jsnhynh/orca/docs/_images/rob-commit-waveform.webp

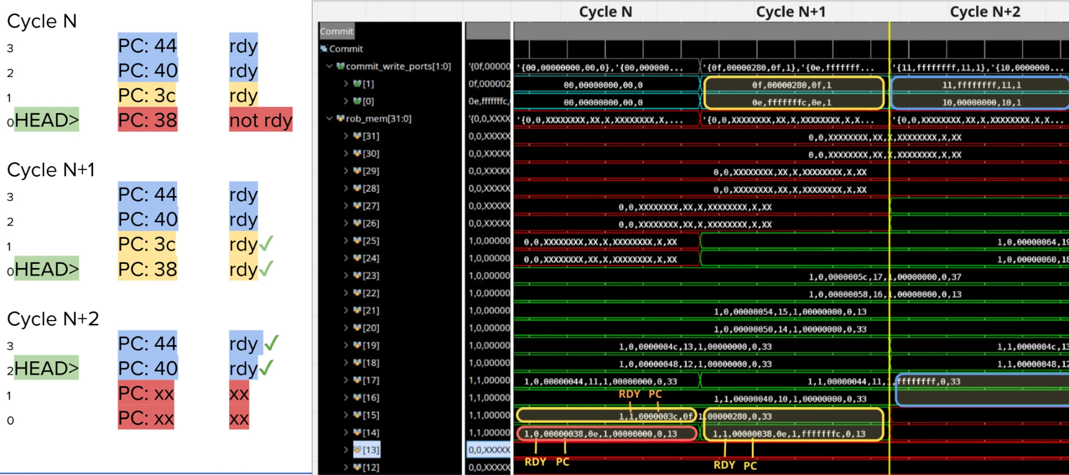
docs/_images/rob-commit-waveform.webp
