jsnhynh/orca/docs/bringup/asic-synthesis.html

Skip to content

ORCA

ORCA

Introduction

- Overview
- Results
- Building

Microarchitecture

- Core
  - Stage 0: Branch Prediction
  - Stage 1: Fetch
  - Stage 2: Decode
  - Stage 3: Rename
  - Stage 4: Dispatch
  - Stage 5: Issue
  - Stage 6: Execute
  - Stage 7: Writeback
  - Stage 8: Commit
  - M Extension: Multiply and Divide
  - A Extension: Atomics
  - Machine-Mode Traps
  - ISA and Software Contract
- Memory
  - L1 Caches
  - Boot ROM
  - DDR and Main Memory
- SoC
  - Interconnect and Clocks
  - Peripherals and Registers
  - FPGA and KV260 Boundary

Verification

- Verification

Bring-Up

- FPGA Bring-Up
- ASIC Synthesis
- Linux Bring-Up

Back to top

# ASIC Synthesis¶

Alongside the FPGA build, the core and its L1 caches (cpu) were synthesized to ASAP7 standard cells and timed with OpenSTA. The result is a pre-layout estimate at the typical corner (0.7 V): it measures the RTL’s logic depth and gives an approximate ASIC frequency, area and leakage for the core.

## 1. Purpose and Scope¶

FPGA timing hides logic depth. A CARRY8 chain and a 6-input LUT absorb structures that take many gate levels in standard cells, and on the KV260 routing makes up 60 to 75% of ORCA’s critical paths. A standard-cell estimate removes both effects and shows how deep the logic itself is, which the FPGA reports cannot.

The flow stops at a synthesized netlist. Physical design (placement, clock tree synthesis and routing) was left out of scope, since the goal was the RTL handoff point and not a full chip. OpenROAD placement remains open as the next step; it would replace the repair scripts described below and measure the real wire cost.

## 2. Yosys and OpenSTA Setup¶

./orca synth   # results in build/synth/cpu/

The flow uses Yosys with the slang SystemVerilog frontend, OpenSTA, and the ASAP7 platform from OpenROAD-flow-scripts, all installed outside the repository.

1. Read. Yosys reads the same rtl/ files as the FPGA build through slang, with cpu as the top. The SoC bus logic is left out.
2. Memories. gen_macros.py describes the ASAP7 fakeram macros to Yosys’s memory mapper, and each array becomes a macro or flops, whichever is smaller. Arrays with multiple write ports, or read in the same cycle their address arrives, become flops, and ROMs become logic. The library only has single-port macros without write masks, so a one-read one-write array uses the single-port cell with a second address bus at twice the area (an assumption, about 30,000 µm² of the total), and each group of bits written together gets its own macro.
3. Adders. Carry chains are mapped to Kogge-Stone prefix trees, the closest standard-cell equivalent to the FPGA carry chain.
4. Logic. ABC maps the remaining logic to regular-threshold (RVT) cells with a delay script, using the block’s input drive and output load.
5. Repair. The netlist is buffered, sized and threshold-mixed by the three scripts in the next section.
6. Timing. OpenSTA times the netlist against a bare 1 ns clock with no uncertainty, and against the handoff constraints in scripts/synth/orca.sdc: 50 ps of uncertainty for a future clock tree and 30% of each cycle reserved at the block boundary for the surrounding SoC. Both values are assumptions.

### Design Decision: One RTL for Both Flows¶

The FPGA and ASIC flows read the same RTL, with memories inferred by each tool. One exception was made. The retire counter adds up to 4 to a 64-bit value every cycle (two retire slots, each possibly a fused pair). On the FPGA this maps onto a carry chain, but Yosys built it as a ripple of about 35 gates, which left the estimate 69 ps short of 1 GHz. When XILINX is not defined, csr.sv uses small_add.sv, which adds the low bits normally and carries into the upper bits through an AND prefix. Vivado defines XILINX and keeps the plain +, so the closed FPGA design is unaffected. A tighter ABC delay target and a hierarchy-keeping option were tried first and did not fix the path.

## 3. Timing Repair¶

Commercial synthesis tools optimize against timing during mapping: they build buffer trees for high fan-out nets, size gates on critical paths and choose a threshold voltage per gate. Yosys and ABC restructure logic for delay but do none of these. ABC also does not see the load of flop and macro pins, so high fan-out nets come out of synthesis driven by single small gates. Three scripts were written to stand in for that step, and they change only cells and wiring, never logic:

- buffer_nets.py splits each net above a fan-out limit into a balanced buffer tree. A second pass reads each sink’s slack from a timing run, keeps the worst sinks on the driver and places the rest behind the tree.
- size_cells.py takes the worst path to each failing endpoint and upsizes its slowest stages by one drive strength. A pass that fails to improve worst slack is reverted, and the next pass touches half as many cells.
- mix_vt.py moves gates on failing paths from RVT to low threshold (LVT) until the clock has the requested margin. On a failing path with no RVT gate left, it upsizes the smallest gates instead.

Run | Worst path | Clock | Logic and flop leakage
Yosys only, RVT | 2,160 ps | about 463 MHz
Yosys only, LVT | 1,663 ps | about 601 MHz
Buffered and sized, RVT | 1,297 ps | about 771 MHz | 0.06 mW
Buffered and sized, LVT | 991 ps | about 1.01 GHz | 0.62 mW
Buffered and sized, SLVT | 911 ps | about 1.1 GHz | 6.2 mW
Shipped: buffered, sized, 98.2% RVT and 1.8% LVT | 1 GHz met | 1 GHz | about 0.09 mW

Buffering and sizing alone removed 40% of the raw path delay.

### Design Decision: Selective LVT vs a Single Threshold¶

An all-RVT netlist stops at about 771 MHz, and an all-LVT netlist reaches 1 GHz at 0.62 mW of logic and flop leakage. Moving only the gates on failing paths to LVT reaches 1 GHz with 1.8% of the cells at LVT and 0.09 mW of leakage. SLVT was not used for the shipped netlist.

## 4. Results¶

| Value
Clock | 1 GHz, typical corner, 0.7 V
Worst setup slack | +30.7 ps on the bare clock; +0.7 ps at the sizing target (30 ps uncertainty); 0 failing endpoints; 150 endpoints within 50 ps
Handoff constraints | misses by 241 ps; the worst path is minstret_r to the perf_stats output port, inside the assumed 30% boundary budget
Threshold mix | 98.2% RVT, 1.8% LVT
Area | about 0.081 mm²: RAM macros 51%, logic 29%, flops 13%, buffers 7%
Logic and flop leakage | about 0.09 mW (library estimate)
Total power | about 529 mW, of which 474 mW is placeholder macro data; with default switching activity and no clock tree, this figure is not usable

The same netlist at the slow corner (LVT with 0.2% SLVT) runs at about 790 MHz, and at the fast corner at about 1.4 GHz. Leakage at those corners came out higher at slow than at fast, the reverse of the expected trend; this has not been explained, so corner leakage is not reported. The fetch-return path into the predictor ranks near the top in both the FPGA and the ASAP7 timing reports.

The timing, area and repair reports are published in results/asap7/; the netlist is not.

The estimate has clear limits. It has no wires, clock tree or skew, and layout would consume more than the reported margin. RAM timing and power come from placeholder fakeram models, and ASAP7 is a predictive library. The netlist has not been simulated or checked for equivalence against the RTL.

Next

Linux Bring-Up

Previous

FPGA Bring-Up

Copyright © 2026 Jason Huynh. All rights reserved.

Made with Sphinx (https://www.sphinx-doc.org/) and @pradyunsg (https://pradyunsg.me)'s Furo (https://github.com/pradyunsg/furo)

On this page

- ASIC Synthesis
  - 1. Purpose and Scope
  - 2. Yosys and OpenSTA Setup
    - Design Decision: One RTL for Both Flows
  - 3. Timing Repair
    - Design Decision: Selective LVT vs a Single Threshold
  - 4. Results
