jsnhynh/orca/docs/building.html

Skip to content

ORCA

ORCA

Introduction

- Overview
- Results
- Building

Microarchitecture

- Core
  - Stage 0: Branch Prediction
  - Stage 1: Fetch
  - Stage 2: Decode
  - Stage 3: Rename
  - Stage 4: Dispatch
  - Stage 5: Issue
  - Stage 6: Execute
  - Stage 7: Writeback
  - Stage 8: Commit
  - M Extension: Multiply and Divide
  - A Extension: Atomics
  - Machine-Mode Traps
  - ISA and Software Contract
- Memory
  - L1 Caches
  - Boot ROM
  - DDR and Main Memory
- SoC
  - Interconnect and Clocks
  - Peripherals and Registers
  - FPGA and KV260 Boundary

Verification

- Verification

Bring-Up

- FPGA Bring-Up
- ASIC Synthesis
- Linux Bring-Up

Back to top

# Building¶

The public repo has a kit to run ORCA on your own Kria KV260. The RTL isn’t published, so the bitstream comes prebuilt, but everything else (Linux, CoreMark, Embench, the architecture tests) runs from one script, src/run.py.

## What you need¶

A KV260 powered on and plugged in over USB, xsdb from AMD Vivado or Vitis 2026.1, and Python 3.9 or newer. Close anything else using the board’s JTAG cable (Vivado’s hardware manager likes to hold onto it). No SD card needed.

## Running it¶

Run these from the folder you downloaded. On Windows use py instead of python3.

python3 src/run.py linux
python3 src/run.py coremark
python3 src/run.py embench
python3 src/run.py act

Command | What it does
linux | boots Linux and opens its console. Log in as root, ctrl-] quits. --tour types a short scripted demo instead.
coremark | runs CoreMark and prints the score, the score per MHz and the IPC
embench | runs the 19 Embench-IoT programs, prints cycles, IPC and time for each, then the speed score
act | runs the 67 RISC-V architecture tests, one bitstream load each. --quick loads it once and finishes in under a minute, and --only add runs just the tests with add in the name.

Every run puts the board in JTAG boot mode, sets up the Arm side, loads the bitstream, starts the console relay and writes the program into DDR (FPGA bring-up). If it can’t find xsdb, add --xsdb /path/to/xsdb.

## What’s in the kit¶

Besides the bitstream, the software all rebuilds from src/ with python3 src/run.py build coremark, build linux or build relay. The logs from my own runs of this exact build (Linux boot, CoreMark, Embench and the architecture tests) are in results/ if you want to compare.

Next

Core

Previous

Results

Copyright © 2026 Jason Huynh. All rights reserved.

Made with Sphinx (https://www.sphinx-doc.org/) and @pradyunsg (https://pradyunsg.me)'s Furo (https://github.com/pradyunsg/furo)

On this page

- Building
  - What you need
  - Running it
  - What’s in the kit
