jsnhynh/orca/docs/results.html

Skip to content

ORCA

ORCA

Introduction

- Overview
- Results
- Building

Microarchitecture

- Core
  - Stage 0: Branch Prediction
  - Stage 1: Fetch
  - Stage 2: Decode
  - Stage 3: Rename
  - Stage 4: Dispatch
  - Stage 5: Issue
  - Stage 6: Execute
  - Stage 7: Writeback
  - Stage 8: Commit
  - M Extension: Multiply and Divide
  - A Extension: Atomics
  - Machine-Mode Traps
  - ISA and Software Contract
- Memory
  - L1 Caches
  - Boot ROM
  - DDR and Main Memory
- SoC
  - Interconnect and Clocks
  - Peripherals and Registers
  - FPGA and KV260 Boundary

Verification

- Verification

Bring-Up

- FPGA Bring-Up
- ASIC Synthesis
- Linux Bring-Up

Back to top

# Results¶

- CoreMark: 1,032 per second at 200 MHz, 5.16 per MHz, IPC 1.51. The board log prints 1,090 because CoreMark rounds its run time down to whole seconds; the cycle count gives 1,032.
- Embench-IoT: 2.31 per MHz over all 19 programs, 461 per second at 200 MHz.
- Branch prediction: 98.9% of conditional branches right on CoreMark, 2.1 mispredictions per thousand instructions.
- Architecture tests: all 67 pass, and each retires exactly the instructions the simulation retires.
- Linux: no-MMU kernel 6.18.7 reaches a shell with 256 MiB of RAM. 40 of 40 boots finished the scripted session.

All the board numbers come from the same prebuilt bitstream and images that ship in the kit, run over JTAG with nothing running on the Arm side. Benchmarks are GCC 15.2 at -O3.

## Linux¶

No-MMU Linux 6.18.7 boots to a BusyBox shell with 256 MiB of RAM. The kernel reaches /init after 1.53 s of kernel time at 200 MHz. How the image is built and loaded is on the Linux bring-up page.

## Timing and size¶

The full SoC closes at 5.0 ns with no failing endpoints. Placement settings move this netlist anywhere from -0.56 to 0.000 ns, so I try several and keep the one that closes. The only on-chip RAM is the L1 caches while programs and data live in the board’s DDR.

Build | LUTs | Registers | Block RAM | DSP | Clock | Setup slack
Full SoC, ran on the board | 36,304 | 19,303 | 25 | 4 | 200 MHz | 0.000 ns
Core + L1 (Out of context) | 28,583 | 11,368 | 21 | 4
Core (Out of context) | 26,422 | 10,404 | 9 | 4

## Where the core’s LUTs go¶

bpu6,365 LUTs

issue5,855 LUTs

execute5,636 LUTs

cpu_l1_subsystem2,052 LUTs

rob1,925 LUTs

fetch1,753 LUTs

rename1,592 LUTs

payload_array1,347 LUTs

cache1,120 LUTs

physical_regfile876 LUTs

decode778 LUTs

icache696 LUTs

These are the largest blocks of the core plus L1 caches after place and route, routed alone out of context, which keeps the blocks apart. The shipped design is flattened for retiming, so its blocks can’t be told apart.

## Core Comparison¶

To get a better idea on how the core performs, I compared ORCA with three of the best/common open-source out-of-order RISC-V cores that I could build and run under similar conditions: NaxRiscv (SpinalHDL), RSD (SystemVerilog) and BOOM (Chisel). I also threw in Arm’s published Cortex-A9 figure as an additional datapoint. I’m sure there are other open cores available but these are the one that I found that are commonly known and can be built as a 2-wide OoO core. Every open core runs the same CoreMark and Embench sources with GCC 15.2 at -O3 and build the same out-of-context Vivado flow on the KV260 part. The scope is the core plus its L1 caches.

| ORCA | NaxRiscv | RSD | BOOM | Cortex-A9*
ISA | RV32IMA | RV32IMA | RV32IM | RV64GC | ARMv7-A
Width | 2-wide | 2-wide | 2-wide | 2-wide | 2-wide
Physical Registers | 64 | 64 | 64 | 80 | not published
ROB | 32 | 64 | 64 | 64 | not published
Load/store queues | 12 + 12 | 16 + 16 | 16 + 16 | 16 + 16 | not published
Branch prediction | L0 target cache, BTB, 4-table TAGE, 16-entry RAS | BTB, GShare, RAS | BTB, GShare, memory dependency predictor | TAGE-L, BTB, RAS | dynamic
Cache Ways | 2 | 4 | 2 | 4 | configurable
L1 I Cache | 32 KiB | 16 KiB | 4 KiB | 16 KiB | configurable
L1 D Cache | 16 KiB | 16 KiB | 4 KiB | 16 KiB | configurable

| ORCA | NaxRiscv | RSD | BOOM | Cortex-A9*
CoreMark/ MHz | 5.14 | 4.66 (-9.3%) | 3.15 (-38.7%) | 4.44 (-13.6%) | 3.66*
CoreMark IPC | 1.50 | 1.36 | 0.92 | 1.50 (64-bit)
CoreMark/s | 1,027 | 932 (-9.3%) | 485 (-52.8%)
Embench/MHz | 2.36 | 2.27 (-3.8%) | 1.24 (-47.5%) | 2.17 (-8.1%)(64-bit)
Clock reached | 200 MHz (full) | 200 MHz (ooc) | 154 MHz (ooc) | no fit
LUTs | 28.6k | 12.0k (-58.0%) | 16.0k (-44.1%) | 123.2k (+330.8%)(synth)
Registers | 11.4k | 7.6k | 9.2k | 62.1k (synth)
Block RAM tiles | 21 | 22.5 | 14.5 | 11 (synth)

* Official single core published Coremark (EEMBC (https://www.eembc.org/coremark/scores.php)).

The results show that our core arguably performs the best in its 2-wide superscalar class, with Nax being the most performant and best 1-1 comparison. ORCA is 10.2% faster in Coremark/s and 4.0% faster on Embench/Mhz then Nax but unfortunately 2.38x larger. This is likely due to our routing logic and larger TAGE based predictor.

## How ORCA compares, in charts¶

CoreMark per MHz. Open cores measured with the same CoreMark source, compiler and flags; * Arm's published figure.

Data

Core | CoreMark per MHz | Note
ORCA | 5.14 | simulation, the 200 MHz board build's RTL
NaxRiscv | 4.66 | simulation
BOOM | 4.44 | simulation, RV64 code, MMU and FPU present; LUTs after synthesis, does not fit the KV260
RSD | 3.15 | simulation
Cortex-A9* | 2.90 | Arm's published figure, not measured here

Embench-IoT speed score per MHz, all 19 programs, same binaries per ISA, each core in its own simulator.

Data

Core | Embench-IoT speed score per MHz | Note
ORCA | 2.36 | simulation, the 200 MHz board build's RTL
NaxRiscv | 2.27 | simulation
BOOM | 2.17 | simulation, RV64 code, MMU and FPU present; LUTs after synthesis, does not fit the KV260
RSD | 1.24 | simulation

LUTs, core plus L1 caches, same KV260 part and Vivado flow (lower is smaller): after place and route, except BOOM, which is after synthesis because it does not fit the part.

Data

Core | LUTs, core plus L1 caches (thousands) | Note
ORCA | 28.6k | simulation, the 200 MHz board build's RTL
NaxRiscv | 12.0k | simulation
BOOM | 123.2k | simulation, RV64 code, MMU and FPU present; LUTs after synthesis, does not fit the KV260
RSD | 16.0k | simulation

## ASIC estimate¶

While the primary implementation target is FPGA, The core and L1 caches was also synthesized using Yosys to meet 1 GHz on ASAP7 standard cells before layout in about 0.081 mm². It’s only an estimate without placement or routing, and fake RAM timing. The timing, area and sizing reports are in results/asap7/, and the flow is on the bring-up page.

## Performance, Area, & Timing Tuning¶

In order to stay competitive, we targeted frequency by reducing structure size tuned by the benchmarks and frequency gains and increased IPC on non critical paths. Utilization managment came well over our competition and so seeking a reduction of half was simply not plausable without major redesign. RTL alone got us to 175 MHz.

At 200MHz we were pushing the limits and trade-offs that set the core’s size and clock. Past 190 MHz every failing path was a complete loop that couldnt be pipelined in half or significanty reduced in structure size to offset routing delay.

RTL timing changes got us from 175 to about 190 MHz, but reaching 200MHz from there simply was EDA tool luck rather then an RTL issue. Remap optimization with net-delay placement and 0.2 ns of extra margin as well as letting LLMs perform a greedy search on all build directive combinations let us close at 200MHz after a weeks long search with each build lasting approximately an hour on a Ryzen 9800x3d. This is a significant milestone as we reach similar frequencies to Nax at even double the size. Most builds closed around 190MHz with good settings.

Each row is one variant against the design it would replace, built and run the same way. Embench and CoreMark columns are the change in score per MHz, so higher is better (for CoreMark that’s fewer cycles for the same work). Net per second multiplies the score change by the clock change. LUTs are core plus L1. Blank means I didn’t measure it for that change.

Change | Embench score/MHz | CoreMark score/MHz | Clock | LUTs | Net per second (Embench / CoreMark) | Verdict
Mispredict redirects the front end at execute, instead of repairing at commit | +2.06% | +0.94% | | +1,041 | | kept
No rename checkpoints | -0.29% | -0.06% | | -1,499 | | kept
12-entry scheduler, instead of a 12-entry ordered window | +12.8% | +14.7% | | +368 (queue) | | kept
Macro-op fusion | +0.35% | +0.10% | same | +255 | +0.4% / +0.1% | kept
Divider skips steps with no quotient bits | +0.55% | 0.00% | same | about 0 | +0.6% / 0.0% | kept
L0 target table, 128 to 512 entries | +1.13% | +0.10% | -1.4% | +1,014 | -0.3% / -1.3% | kept
ROB, 64 to 32 entries | -0.1% | 0.0% | | | | kept
Split store, 12-entry scheduler | +1.02% | +0.25% | same | +1,153 | +1.0% / +0.2% | dropped: 3% more area for 1%
Split store, 16-entry scheduler | +1.53% | +0.47% | -1.7% | +2,115 | -0.2% / -1.2% | dropped
Load and store queues, 12 to 16 | +1.05% | 0.00% | -5.5% | more | -4.5% / -5.5% | dropped
Load and store queues, 12 to 8 | -3.0% | -0.7% | | -2,700 | | dropped
Scheduler, 12 to 8 entries | -4.1% | -4.4% | worse | | | dropped
128 physical registers | +0.56% | +0.60% | -1.6% | +2,100 | -1.0% / -1.0% | dropped
TAGE, 1,024 to 2,048 entries | +0.88% | +0.09% | -5.7% | block RAM | -4.9% / -5.6% | dropped
Load result one cycle sooner | +0.36% | +1.33% | -7.9% | +422 | -7.6% / -6.7% | dropped
All the larger sizes together | +4.14% | +1.55% | -4.6% | +7,077 | -0.7% / -3.1% | dropped

### PULP IP vs Xilinx IP¶

For the SoC components I chose PULP IP for the AXI crossbar and UART 16550. I also attempted to use Xilinx’s IP which saved about 3,000 LUTs with no performance variance, however I was unable to close 200MHz out of 20 builds due to seed/placement variance. I did NOT want to do another week’s worth of searching. PULP IP was kept. It might also be useful if I ever plan on doing the full ASIC flow.

Next

Building

Previous

Home

Copyright © 2026 Jason Huynh. All rights reserved.

Made with Sphinx (https://www.sphinx-doc.org/) and @pradyunsg (https://pradyunsg.me)'s Furo (https://github.com/pradyunsg/furo)

On this page

- Results
  - Linux
  - Timing and size
  - Where the core’s LUTs go
  - Core Comparison
  - How ORCA compares, in charts
  - ASIC estimate
  - Performance, Area, & Timing Tuning
    - PULP IP vs Xilinx IP
